danngreen/ir-remote/pcb/production/jlcpcb-ordered-downloaded/parts not placed.xlsx

?Designator | Value | Footprint | Quantity
L3 | 10uH_0805_0.5A | 0805 | 1
U1 | STM32G431CBTx | LQFP-48_7x7mm_P0.5mm | 1
R4 | 71.5k_0603 | R_0603 | 1
L11 | 4.7uH_1.2A_40xx | L_Taiyo-Yuden_NR-40xx | 1
R27 | 10.2k_0603 | R_0603 | 1
V12 | NCP51460SN33 | SOT23-3_PO132 | 1
R25 | 31.6k_0603 | R_0603 | 1
J12 | Conn_01x04 | Pins_1x04_2.54mm_TH_SWD | 1
TP1,TP11,TP12,TP13,TP14,TP2,TP3,TP4,TP5,TP6,TP7,TP8 | TestPoint | TestPoint_WireHole | 12
J1,J2,J8 | Conn_01x02 | Pins_1x02_2.54mm_TH | 3
J6 | Conn_01x03 | Pins_1x03_2.54mm_TH | 1
J3 | Pins_02x04_P2.54mm_SMT | Pins_2x04_P2.54mm_Vertical_SMD | 1
