danngreen/ir-remote/pcb/production/jlcpcb-ordered-downloaded/parts used.xls

Comment | Designator | Footprint | JLCPCB Part #
47nF_0603_35V | C22,C23 | C_0603 | C1622
USBLC6-2SC6 | U6 | SOT-23-6 | C2827654
DRV8210DRLR | U7 | SOT-563 | C3681297
TAR5S33U | U8 | SOT-563-5 | C3745113
47pF_0603_50V | C7,C8 | C_0603 | C1671
22uF_1206_25V | C17,C18,C36,C37,C39 | C_1206 | C12891
27Ω_0603 | R2,R3,R6,R7,R8 | R_0603 | C23140
100nF_0603_16V | C1,C12,C14,C3,C33,C9,C31,C34,C35,C4 | C_0603 | C14663
100k_0603 | R14,R15,R26 | R_0603 | C25803
USB-C_Receptacle_Molex_2171790001 | J4 | USB_C_Receptacle_Molex_2171790001 | C2894899
16MHz_18pF_FA238 | X10 | FA-238 | C13738
5.1k_0603 | R17,R18 | R_0603 | C23186
10uF_0603_10V | C10,C11,C13,C15,C27,C28,C29,C30,C5 | C_0603 | C19702
1k_0603 | R10,R11 | R_0603 | C21190
10uF_0805_25V | C303,C38,C6 | C_0805 | C15850
1uF_0402_25V | C300 | C_0402 | C52923
100Ω_0603 | R13,R16 | R_0603 | C22775
TLV61046ADB | U112 | SOT-23-6 | C464815
15k_0603 | R1 | R_0603 | C22809
2.2uF_0603_25V | C40 | C_0603 | C23630
TLV74018 | U3,U4 | SOT-23-5 | C3746861
1uF_0603_25V | C16,C19,C2,C20,C21,C26,C32 | C_0603 | C15849
AP62200WU-7 | V11 | TSOT-23-6 | C1323282
TLV320AIC3204 | U5 | QFN-32-1EP_5x5mm_P0.5mm_EP3.45x3.45mm_ThermalVias | C24109
10k_0603 | R5 | R_0603 | C25804
4.7k_0603 | R12,R9 | R_0603 | C23162
18pF_0603_50V | C24,C25 | C_0603 | C1647
