danngreen/ir-remote/pcb/production/jlcpcb-ordered-downloaded/gerbers/yg/GBR_10535677_1_bottom.png

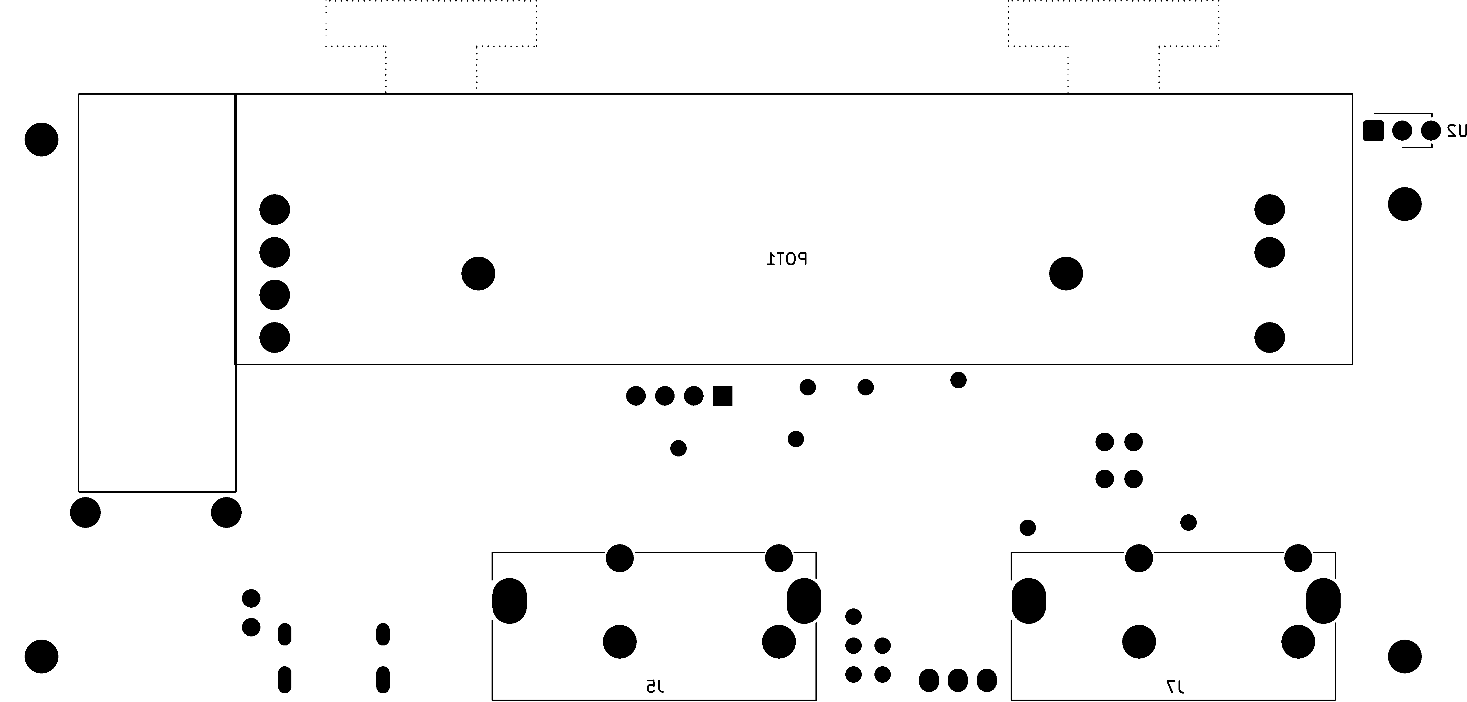
pcb/production/jlcpcb-ordered-downloaded/gerbers/yg/GBR_10535677_1_bottom.png
