danngreen/ir-remote/pcb/production/jlcpcb-ordered-downloaded/gerbers/yg/GBR_10535677_1_snapshot.png

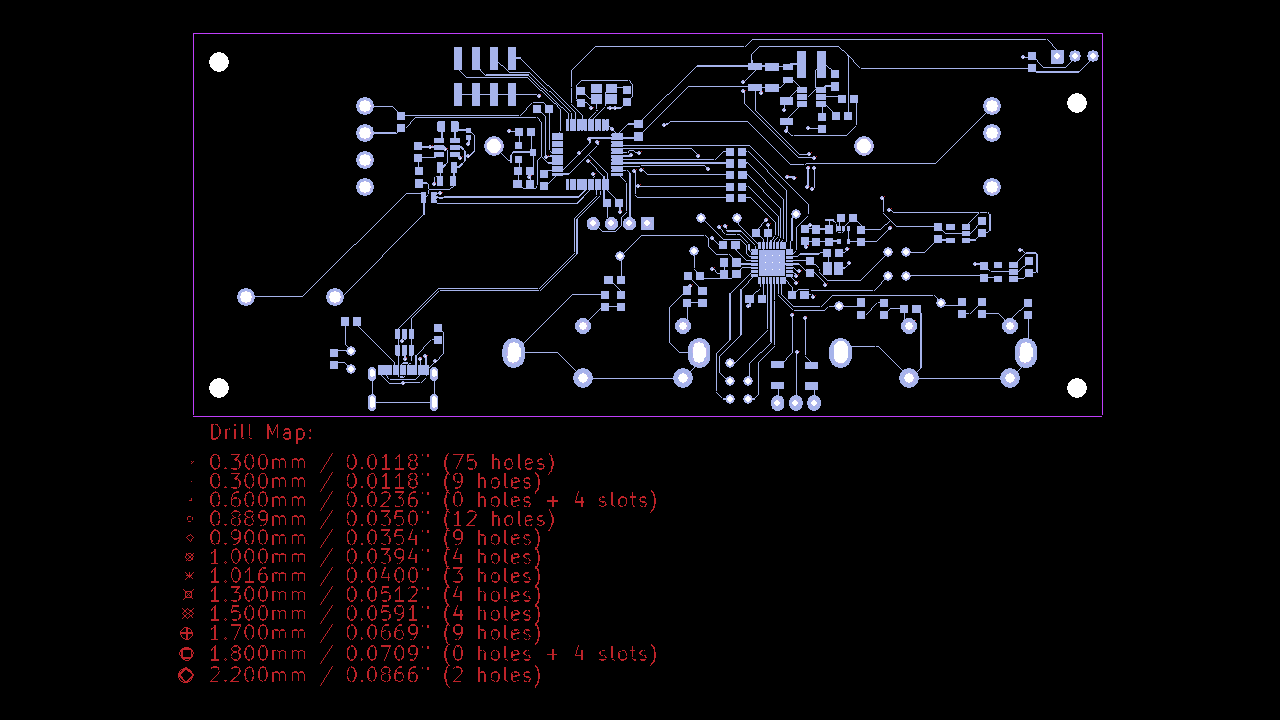
pcb/production/jlcpcb-ordered-downloaded/gerbers/yg/GBR_10535677_1_snapshot.png
