danngreen/ir-remote/enclosure/enclosure.FCStd

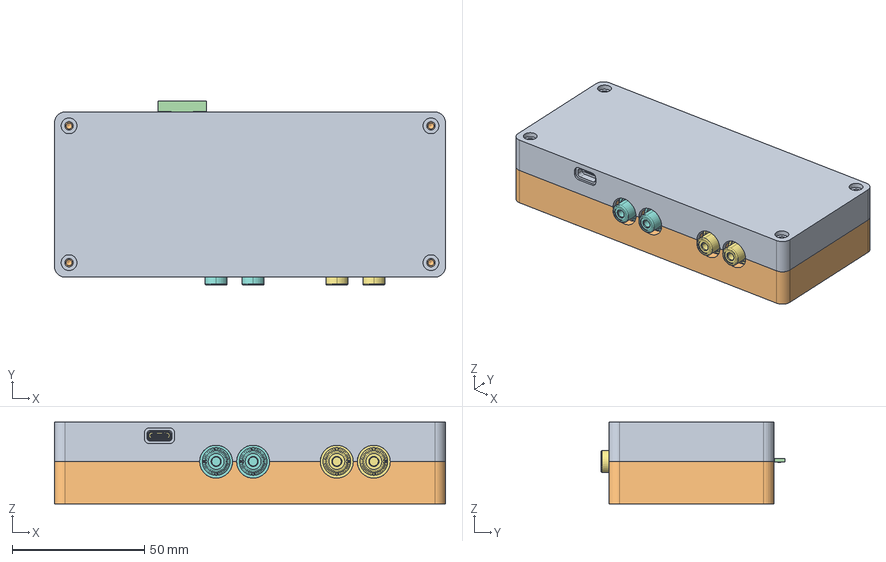
[picture p4: CAD file, 2026-01-19]
enclosure/enclosure.FCStd
147.9 x 69.8 x 31.0 mm
Bottom Enclosure
Top Enclosure
C_0603_1608Metric
C_0603_1608Metric066
C_1206_3216Metric
C_0603_1608Metric067
C_0603_1608Metric068
C_0603_1608Metric069
C_0603_1608Metric070
C_0603_1608Metric071
C_0603_1608Metric072
SOT-23-6
C_0603_1608Metric073
C_1206_3216Metric010
C_0603_1608Metric074
C_0603_1608Metric075
C_0603_1608Metric076
C_0603_1608Metric077
C_0603_1608Metric078
C_1206_3216Metric011
C_0603_1608Metric079
C_0603_1608Metric080
C_0603_1608Metric081
C_0603_1608Metric082
C_0603_1608Metric083
C_0603_1608Metric084
C_0603_1608Metric085
LQFP-48_7x7mm_P0.5mm
C_0603_1608Metric086
C_0603_1608Metric087
C_0603_1608Metric088
C_0603_1608Metric089
QFN-32-1EP_5x5mm_P0.5mm_EP3.45x3.45mm
C_1206_3216Metric012
C_0805_2012Metric
C_0603_1608Metric090
C_0603_1608Metric091
C_1206_3216Metric013
C_0603_1608Metric092
C_0603_1608Metric093
C_0603_1608Metric094
TSOT-23-6
C_0603_1608Metric095
C_0805_2012Metric006
C_0603_1608Metric096
SOT-23-010
C_0603_1608Metric097
SOT-563
C_0805_2012Metric007
C_0402_1005Metric
Vishay_MINICAST-3Pin
pjras2x1s_series
pjras2x1s_series005
ir-remote_PCB
