danngreen/ir-remote/enclosure/production/enclosure-top.step

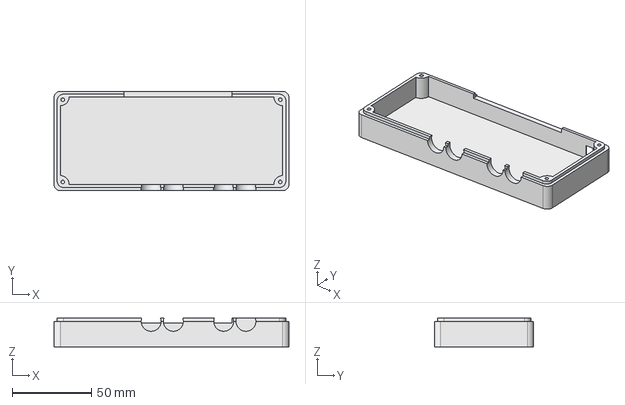
[picture p5: CAD file, 2026-01-19]
enclosure/production/enclosure-top.step
147.9 x 62.5 x 18.0 mm
