danngreen/ir-remote/enclosure/production/enclosure-bottom.step

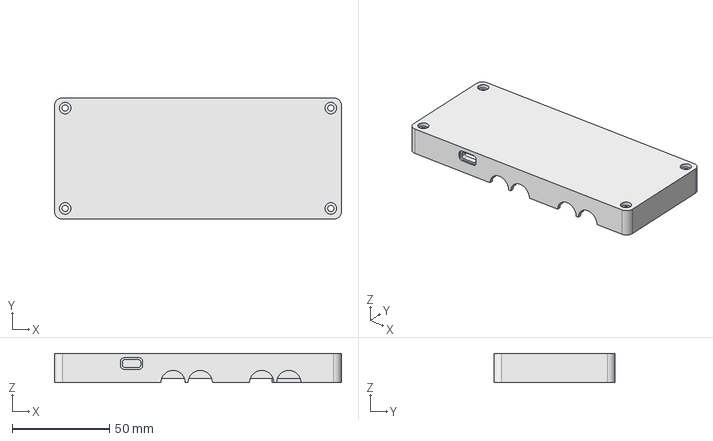
[picture p6: CAD file, 2026-01-19]
enclosure/production/enclosure-bottom.step
147.9 x 62.5 x 15.0 mm
