danngreen/ir-remote/pcb/ir-remote.kicad_pcb

## KiCad design pcb/ir-remote.kicad_pcb (2026-01-19)

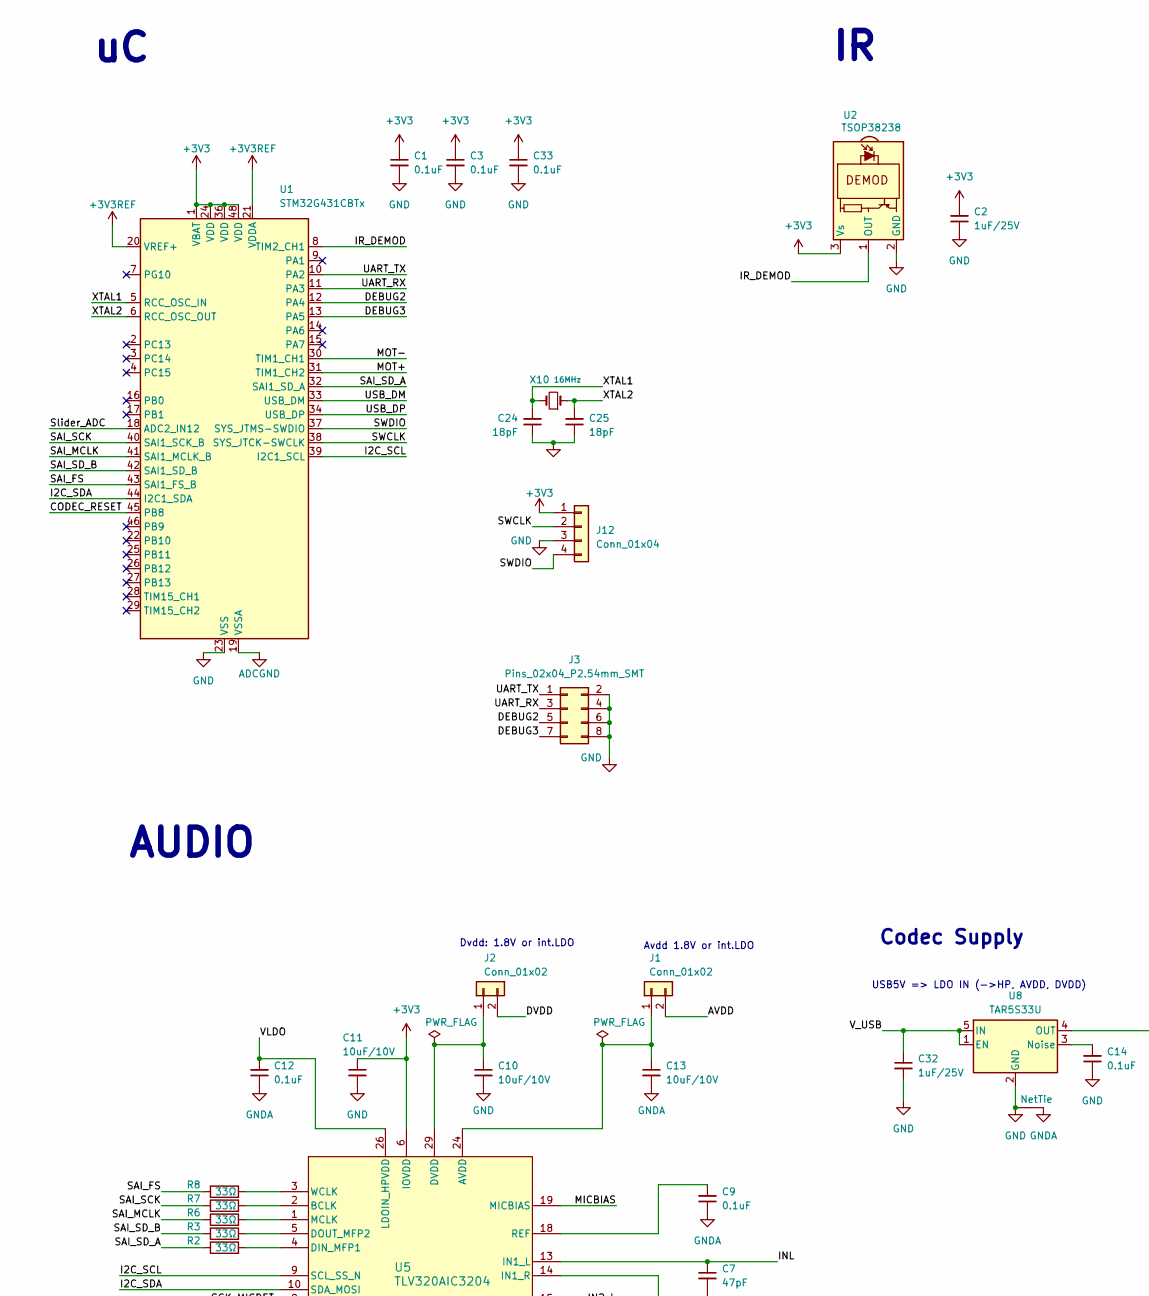
[picture p7: schematic ir-remote.kicad_sch, part in row 1, column 1]

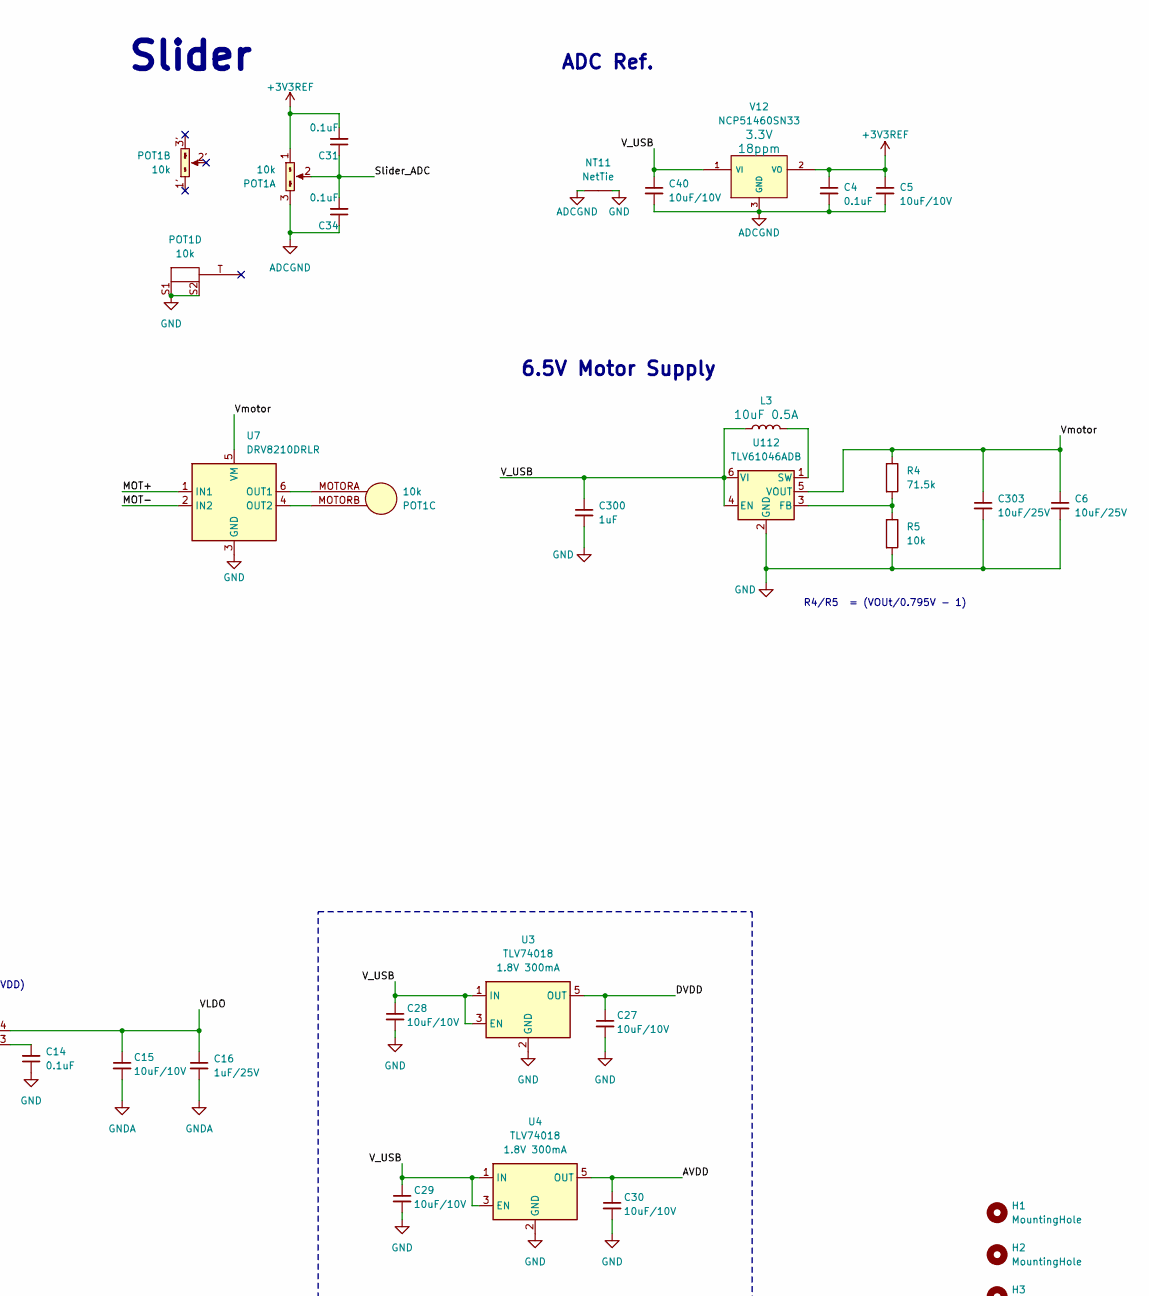
[picture p8: schematic ir-remote.kicad_sch, part in row 1, column 2]

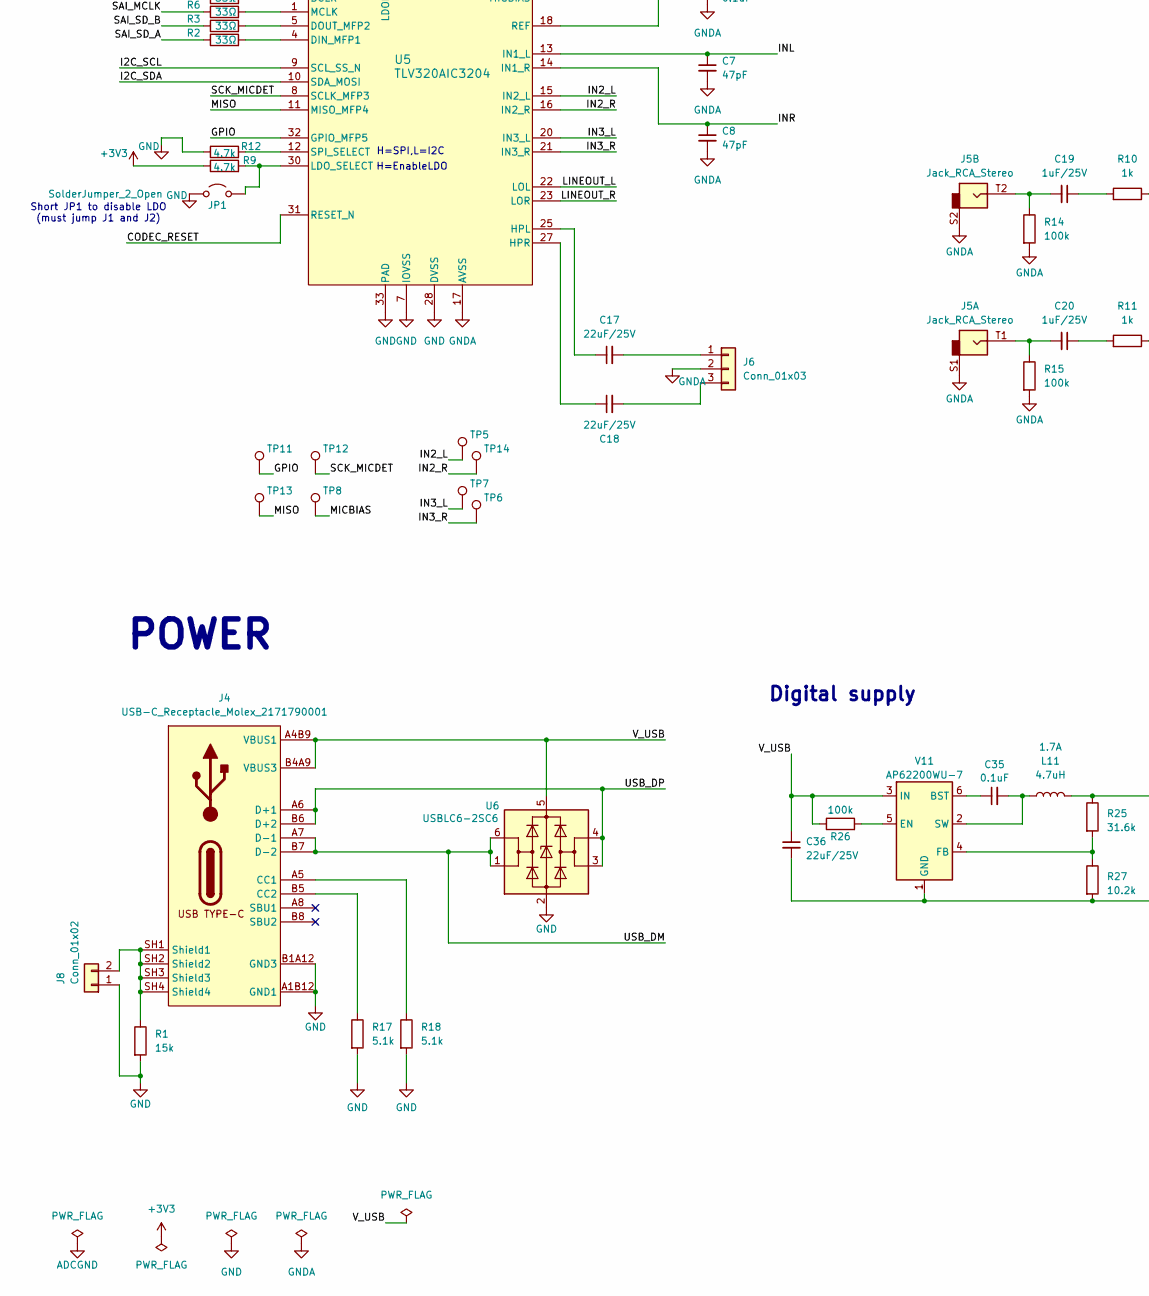
[picture p9: schematic ir-remote.kicad_sch, part in row 2, column 1]

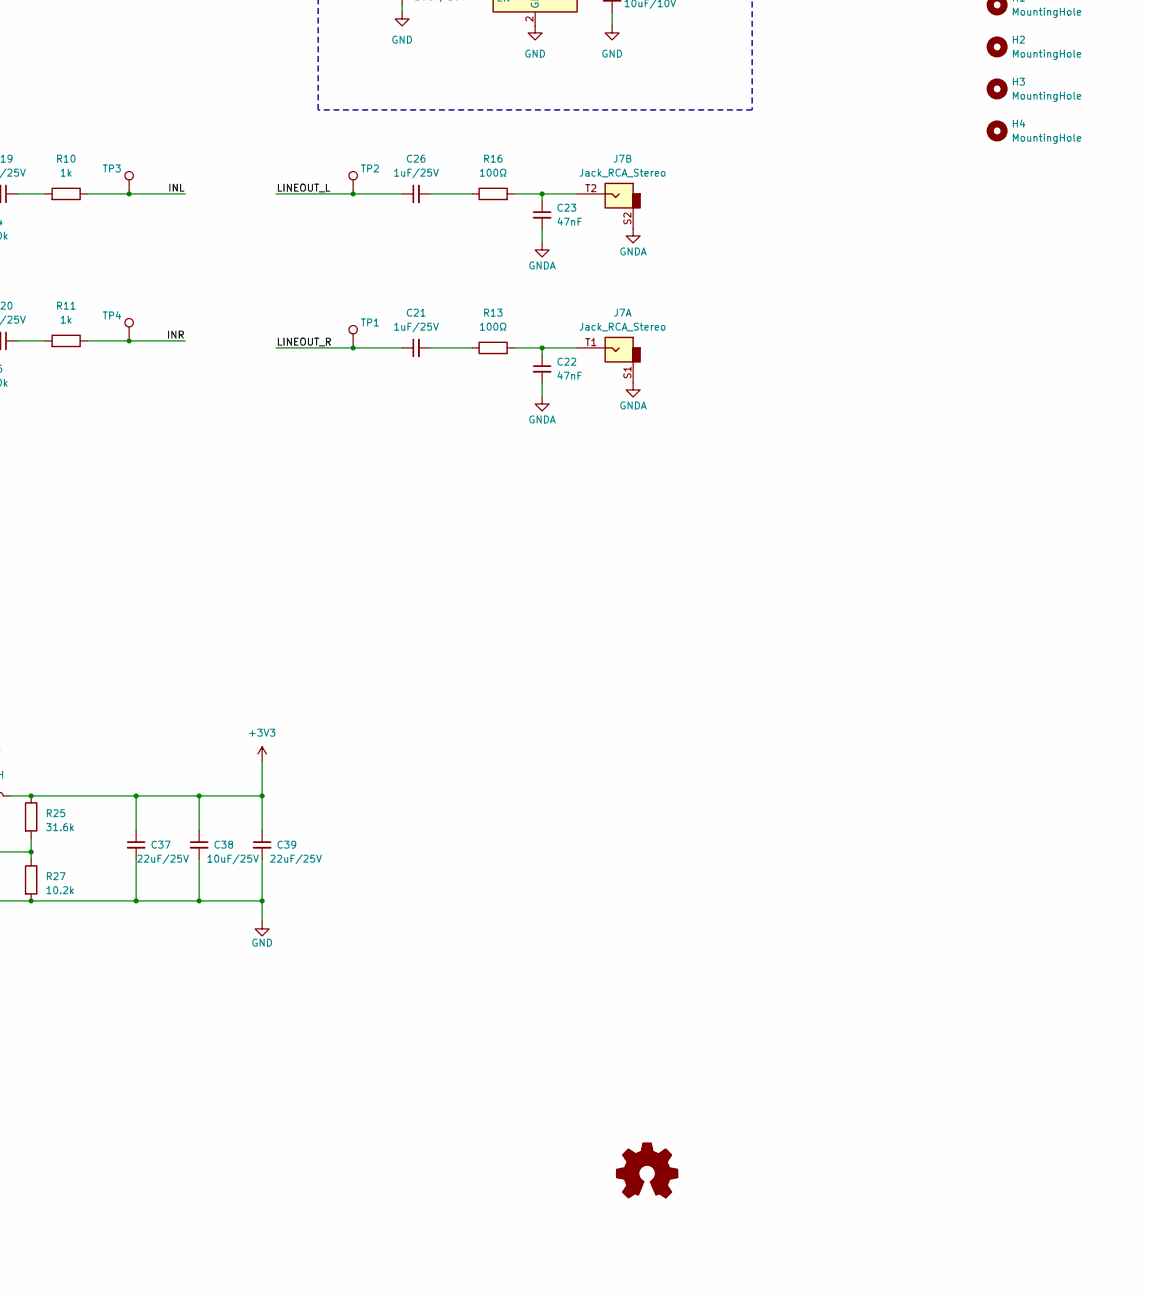
[picture p10: schematic ir-remote.kicad_sch, part in row 2, column 2]

Parts:
C1, C3, C9, C12, C14, C33: 0.1uF_0603_16V; C_0603; Part Number 0603YC104KAT2A; JLCPCB ID C14663
C2, C16, C19, C20, C21, C26, C32: 1uF_0603_25V; C_0603; Part Number GRM188R61E105KA12D; JLCPCB ID C15849
C4, C31, C34, C35: 100nF_0603_16V; C_0603; Part Number 0603YC104KAT2A; JLCPCB ID C14663
C5, C10, C11, C13, C15, C27, C28, C29, C30, C40: 10uF_0603_10V; C_0603; Part Number GRM188R61A106KE69D; JLCPCB ID C19702
C6, C38, C303: 10uF_0805_25V; C_0805; Part Number GRM21BR61E106MA73L; JLCPCB ID C15850
C7, C8: 47pF_0603_50V; C_0603; Part Number CC0603JRNPO9BN470; JLCPCB ID C1671
C17, C18, C36, C37, C39: 22uF_1206_25V; C_1206; Part Number TMK316BBJ226ML-T; JLCPCB ID C12891
C22, C23: 47nF_0603_35V; C_0603; Part Number CC0603KRX7R9BB473; JLCPCB ID C1622
C24, C25: 18pF_0603_50V; C_0603; Part Number C0603C180J5GACTU; JLCPCB ID C1647
C300: 1uF_0402_25V; C_0402; Part Number GMK105CC6105KV-F; JLCPCB ID C52923
H1, H2, H3, H4: MountingHole; MountingHole_Screw_3mmHole_5.3mmHead
J1, J2, J8: Conn_01x02; Pins_1x02_2.54mm_TH; Part Number 1-0201FBV0T
J3: Pins_02x04_P2.54mm_SMT; Pins_2x04_P2.54mm_Vertical_SMD; Part Number TSM-104-01-F-DV
J4: USB-C_Receptacle_Molex_2171790001; USB_C_Receptacle_Molex_2171790001; Part Number 217179-0001; JLCPCB ID C2894899
J5, J7: Jack_RCA_Stereo; RCA_Stereo_SwitchCraft-PJRAS2X1S; Part Number PJRAS2X1S01AUX
J6: Conn_01x03; Pins_1x03_2.54mm_TH; Part Number 1-0301FBV0T
J12: Conn_01x04; Pins_1x04_2.54mm_TH_SWD; Part Number 1-0401FBV0T
JP1: SolderJumper_2_Open; JUMPER_SMD_1x2
L3: 10uH_0805_0.5A; R_0805_2012Metric; Part Number MLZ2012N100L; JLCPCB ID C88182
L11: 4.7uH_1.2A_40xx; L_Taiyo-Yuden_NR-40xx; Part Number NRS4018T4R7MDGJ; JLCPCB ID C92936
NT2, NT11: NetTie; NetTie-2_SMD_Pad0.16mm_6mil; Part Number Do Not Place
POT1: Slider_Dual_Motorized_PSM60-081A-xxx; Part Number PSM60-081A-103B2
R1: 15k_0603; R_0603; Part Number RC0603FR-0715KL; JLCPCB ID C114661
R2, R3, R6, R7, R8: 33Ω_0603; R_0603; Part Number RC0603FR-0733RL; JLCPCB ID C23140
R4: 71.5k_0603; R_0603; Part Number RC0603FR-0771K5L; JLCPCB ID C185312
R5: 10k_0603; R_0603; Part Number RC0603FR-0710KL; JLCPCB ID C98220
R9, R12: 4.7k_0603; R_0603; Part Number RC0603FR-074K7L; JLCPCB ID C99782
R10, R11: 1k_0603; R_0603; Part Number RC0603FR-071KL; JLCPCB ID C22548
R13, R16: 100Ω_0603; R_0603; Part Number RC0603FR-07100RL; JLCPCB ID C105588
R14, R15, R26: 100k_0603; R_0603; Part Number RC0603FR-07100KL; JLCPCB ID C14675
R17, R18: 5.1k_0603; R_0603; Part Number RC0603FR-075K1L; JLCPCB ID C105580
R25: 31.6k_0603; R_0603; Part Number RC0603FR-0731K6L; JLCPCB ID C185339
R27: 10.2k_0603; R_0603; Part Number RC0603FR-0710K2L; JLCPCB ID C183219
TP1, TP2, TP3, TP4, TP5, TP6, TP7, TP8, TP11, TP12, TP13, TP14: TestPoint; TestPoint_WireHole
U1: STM32G431CBTx; LQFP-48_7x7mm_P0.5mm; JLCPCB ID C529355
U2: TSOP38238; Vishay_MINICAST-3Pin
U3, U4: TLV74018; SOT-23-5; Part Number TLV74018PDBVR; JLCPCB ID C3746861
U5: TLV320AIC3204; QFN-32-1EP_5x5mm_P0.5mm_EP3.45x3.45mm_ThermalVias; Part Number TLV320AIC3204IRHBR; JLCPCB ID C24109
U6: USBLC6-2SC6; SOT-23-6; Part Number USBLC6-2SC6; JLCPCB ID C2827654
U7: DRV8210DRLR; SOT-563; Part Number DRV8210DRLR; JLCPCB ID C3681297
U8: TAR5S33U; SOT-563-5; Part Number TAR5S33UTE85LF; JLCPCB ID C3745113
U112: TLV61046ADB; SOT-23-6; Part Number TLV61046ADBVR; JLCPCB ID C464815
V11: AP62200WU-7; TSOT-23-6; Part Number AP62200WU7; JLCPCB ID C1323282
V12: NCP51460SN33; SOT23-3_PO132; Part Number NCP51460SN33T1G; JLCPCB ID C233715
X10: 16MHz_18pF_FA238; FA-238; Part Number TSX-3225 16.0000MF18X-AC3; JLCPCB ID C90906

Connections:
+3V3: C1.1, C2.2, C3.1, C11.1, C33.1, C37.1, C38.1, C39.1, J12.1, L11.2, R9.1, R25.1, U1.1 (VBAT), U1.24 (VDD), U1.36 (VDD), U1.48 (VDD), U2.3 (Vs), U5.6 (IOVDD)
+3V3REF: C4.1, C5.1, C31.2, POT1.1 (Left), U1.20 (VREF+), U1.21 (VDDA), V12.2 (VO)
/AVDD: C30.1, J1.2, U4.5 (OUT)
/CODEC_RESET: U1.45 (PB8), U5.31 (RESET_N)
/DEBUG2: J3.5, U1.12 (PA4)
/DEBUG3: J3.7, U1.13 (PA5)
/DVDD: C27.1, J2.2, U3.5 (OUT)
/GPIO: TP11.1, U5.32 (GPIO_MFP5)
/I2C_SCL: U1.39 (I2C1_SCL), U5.9 (SCL_SS_N)
/I2C_SDA: U1.44 (I2C1_SDA), U5.10 (SDA_MOSI)
/IN2_L: TP5.1, U5.15 (IN2_L)
/IN2_R: TP14.1, U5.16 (IN2_R)
/IN3_L: TP7.1, U5.20 (IN3_L)
/IN3_R: TP6.1, U5.21 (IN3_R)
/INL: C7.1, R10.1, TP3.1, U5.13 (IN1_L)
/INR: C8.1, R11.1, TP4.1, U5.14 (IN1_R)
/IR_DEMOD: U1.8 (TIM2_CH1), U2.1 (OUT)
/LINEOUT_L: C26.1, TP2.1, U5.22 (LOL)
/LINEOUT_R: C21.1, TP1.1, U5.23 (LOR)
/MICBIAS: TP8.1, U5.19 (MICBIAS)
/MISO: TP13.1, U5.11 (MISO_MFP4)
/MOT+: U1.31 (TIM1_CH2), U7.1 (IN1)
/MOT-: U1.30 (TIM1_CH1), U7.2 (IN2)
/SAI_FS: R8.1, U1.43 (SAI1_FS_B)
/SAI_MCLK: R6.1, U1.41 (SAI1_MCLK_B)
/SAI_SCK: R7.1, U1.40 (SAI1_SCK_B)
/SAI_SD_A: R2.1, U1.32 (SAI1_SD_A)
/SAI_SD_B: R3.1, U1.42 (SAI1_SD_B)
/SCK_MICDET: TP12.1, U5.8 (SCLK_MFP3)
/SWCLK: J12.2, U1.38 (SYS_JTCK-SWCLK)
/SWDIO: J12.4, U1.37 (SYS_JTMS-SWDIO)
/Slider_ADC: C31.1, C34.2, POT1.2 (Center), U1.18 (ADC2_IN12)
/UART_RX: J3.3, U1.11 (PA3)
/UART_TX: J3.1, U1.10 (PA2)
/USB_DM: J4.A7 (D-1), J4.B7 (D-2), U1.33 (USB_DM), U6.1 (I/O1), U6.6 (I/O1)
/USB_DP: J4.A6 (D+1), J4.B6 (D+2), U1.34 (USB_DP), U6.3 (I/O2), U6.4 (I/O2)
/VLDO: C12.2, C15.1, C16.1, U5.26 (LDOIN_HPVDD), U8.4 (OUT)
/V_USB: C28.1, C29.1, C32.1, C36.1, C40.1, C300.1, J4.A4B9 (VBUS1), J4.B4A9 (VBUS3), L3.1, R26.1, U3.1 (IN), U3.3 (EN), U4.1 (IN), U4.3 (EN), U6.5 (VBUS), U8.1 (EN), U8.5 (IN), U112.4 (EN), U112.6 (VI), V11.3 (IN), V12.1 (VI)
/Vmotor: C6.1, C303.1, R4.1, U7.5 (VM), U112.5 (VOUT)
/XTAL1: C24.2, U1.5 (RCC_OSC_IN), X10.2
/XTAL2: C25.2, U1.6 (RCC_OSC_OUT), X10.1
ADCGND: C4.2, C5.2, C34.1, C40.2, NT11.1, POT1.3 (Right), U1.19 (VSSA), V12.3 (GND)
GND: C1.2, C2.1, C3.2, C6.2, C10.2, C11.2, C14.1, C24.1, C25.1, C27.2, C28.2, C29.2, C30.2, C32.2, C33.2, C36.2, C37.2, C38.2, C39.2, C300.2, C303.2, J3.2, J3.4, J3.6, J3.8, J4.A1B12 (GND1), J4.B1A12 (GND3), J8.1, J12.3, JP1.1 (A), NT2.1, NT11.2, POT1.S1 (GND), POT1.S2 (GND), R1.2, R5.2, R12.1, R17.2, R18.2, R27.2, U1.23 (VSS), U1.35 (VSS), U1.47 (VSS), U2.2 (GND), U3.2 (GND), U4.2 (GND), U5.7 (IOVSS), U5.28 (DVSS), U5.33 (PAD), U6.2 (GND), U7.3 (GND), U8.2 (GND), U112.2 (GND), V11.1 (GND)
GNDA: C7.2, C8.2, C9.1, C12.1, C13.2, C15.2, C16.2, C22.2, C23.2, J5.S1, J5.S2, J6.2, J7.S1, J7.S2, NT2.2, R14.2, R15.2, U5.17 (AVSS)
unnamed: C19.1, R10.2
unnamed: C19.2, J5.T2, R14.1
unnamed: C20.1, R11.2
unnamed: C20.2, J5.T1, R15.1
unnamed: C21.2, R13.1
unnamed: C22.1, J7.T1, R13.2
unnamed: C23.1, J7.T2, R16.2
unnamed: C26.2, R16.1
unnamed: C13.1, J1.1, U5.24 (AVDD)
unnamed: C10.1, J2.1, U5.29 (DVDD)
unnamed: J4.A5 (CC1), R18.1
unnamed: J4.B5 (CC2), R17.1
unnamed: J4.SH1 (Shield1), J4.SH2 (Shield2), J4.SH3 (Shield3), J4.SH4 (Shield4), J8.2, R1.1
unnamed: C17.2, J6.1
unnamed: C18.2, J6.3
unnamed: JP1.2 (B), R9.2, U5.30 (LDO_SELECT)
unnamed: R7.2, U5.2 (BCLK)
unnamed: R2.2, U5.4 (DIN_MFP1)
unnamed: R3.2, U5.5 (DOUT_MFP2)
unnamed: C17.1, U5.25 (HPL)
unnamed: C18.1, U5.27 (HPR)
unnamed: R6.2, U5.1 (MCLK)
unnamed: C9.2, U5.18 (REF)
unnamed: R12.2, U5.12 (SPI_SELECT)
unnamed: R8.2, U5.3 (WCLK)
unnamed: POT1.MOTORA, U7.6 (OUT1)
unnamed: POT1.MOTORB, U7.4 (OUT2)
unnamed: C14.2, U8.3 (Noise)
unnamed: R4.2, R5.1, U112.3 (FB)
unnamed: L3.2, U112.1 (SW)
unnamed: C35.1, V11.6 (BST)
unnamed: R26.2, V11.5 (EN)
unnamed: R25.2, R27.1, V11.4 (FB)
unnamed: C35.2, L11.1, V11.2 (SW)

Notes on the sheet:
H=SPI,L=I2C
Slider
Codec Supply
R4/R5 = (VOUt/0.795V - 1)
POWER
H=EnableLDO
Digital supply
Dvdd: 1.8V or int.LDO
USB5V => LDO IN (->HP, AVDD, DVDD)
Avdd 1.8V or int.LDO
Short JP1 to disable LDO (must jump J1 and J2)
AUDIO
6.5V Motor Supply
ADC Ref.

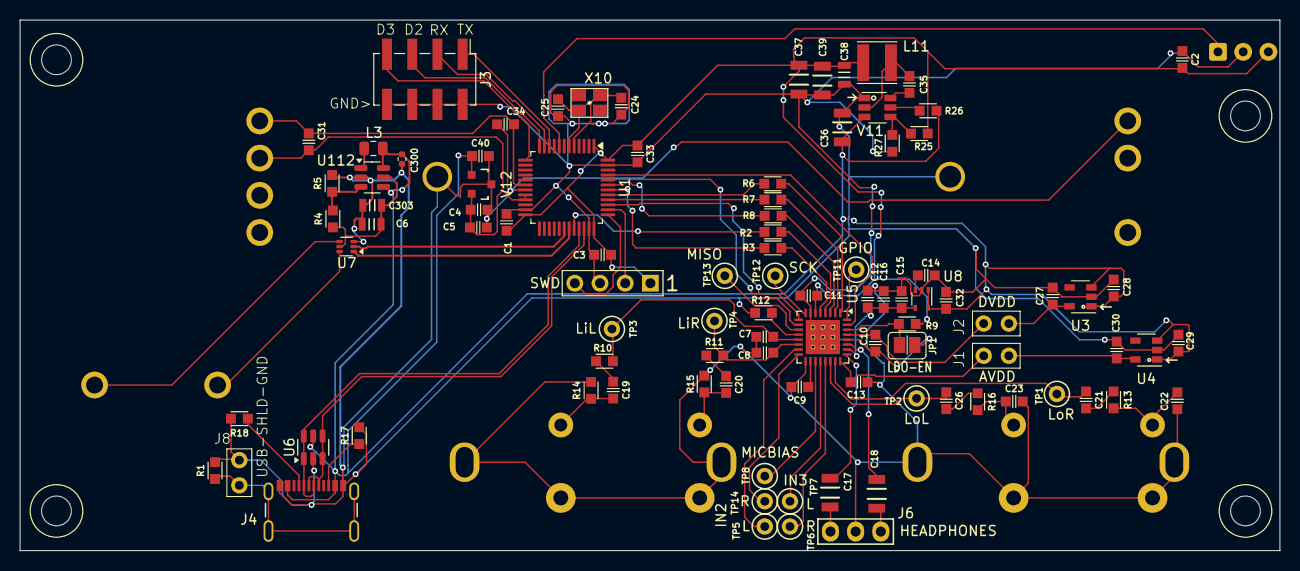
[picture p11: board ir-remote.kicad_pcb from above]

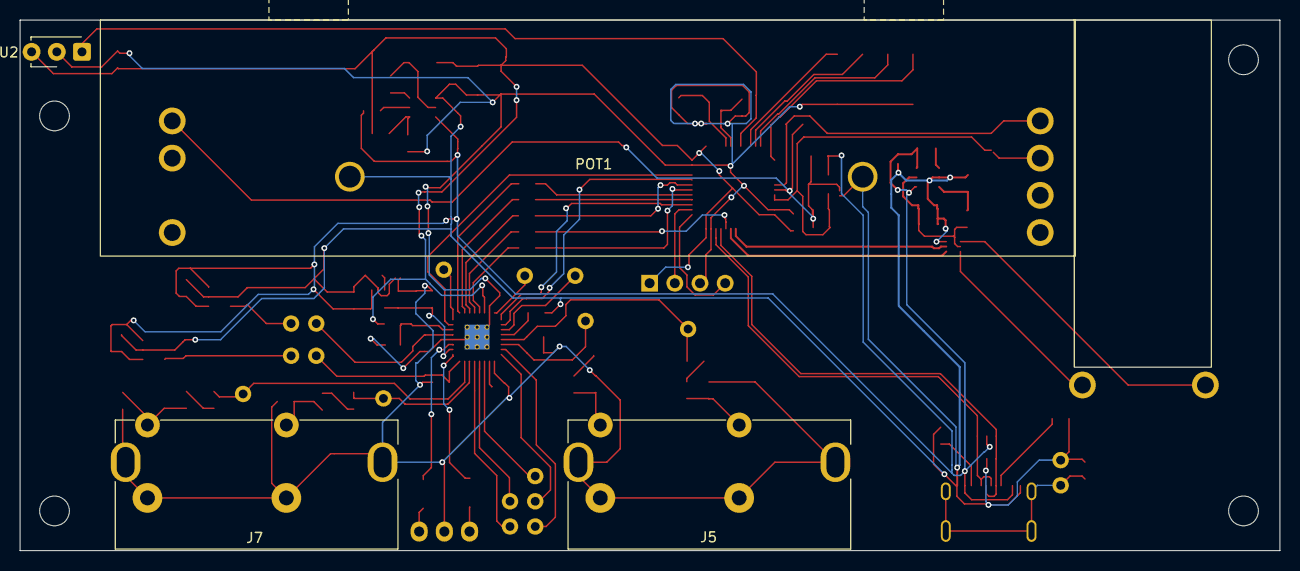
[picture p12: board ir-remote.kicad_pcb from below]

Board: 2 copper layers, 127.0 x 53.5 mm, 106 parts (4 on the bottom side), 78 nets.
