danngreen/ir-remote/cubemx/ir-remote.ioc

Mcu.UserName=STM32G431CBTx
PA10.Signal=SAI1_SD_A
PA11.Signal=USB_DM
PA12.Signal=USB_DP
PA13.Signal=SYS_JTMS-SWDIO
PA14.Signal=SYS_JTCK-SWCLK
PA15.Signal=I2C1_SCL
PA2.Signal=USART2_TX
PA3.Signal=USART2_RX
PB2.Signal=ADC2_IN12
PB3.Signal=SAI1_SCK_B
PB4.Signal=SAI1_MCLK_B
PB5.Signal=SAI1_SD_B
PB6.Signal=SAI1_FS_B
PB7.Signal=I2C1_SDA
PF0-OSC_IN.Signal=RCC_OSC_IN
PF1-OSC_OUT.Signal=RCC_OSC_OUT
