danngreen/ir-remote/(commit log)

2025-12-08 Made ir receiver into a class
    Revert edits to stm32cubemx/CMakeLists (except main.c=>main.cc)
    [capture.cc, main.cc]
2025-12-15 Add schematic and PCB (WIP)
    [ir-remote.kicad_pcb, ir-remote.kicad_sch]
2025-12-19 PCB WIP
    [ir-remote.kicad_pcb, ir-remote.kicad_sch]
2026-01-02 PCB routed and ready for review
    [bom.csv, designators.csv, ir-remote.kicad_pcb, ir-remote.kicad_sch, positions.csv]
2026-01-02 Adjust PCB edges and mounting holes to fit enclosure
    [ir-remote.kicad_pcb, ir-remote.kicad_sch]
2026-01-02 Enclosure 3D started
    [enclosure.FCStd]
2026-01-02 Exported JLCPCB production files
    [bom.csv, designators.csv, positions.csv]
2026-01-02 WIP Enclosure
    [enclosure.FCStd, ir-remote.kicad_pcb]
2026-01-02 Remove rounded corners on PCB
    [ir-remote.kicad_pcb]
2026-01-03 Enclosure and PCB matched and fit
    [enclosure.FCStd, ir-remote.kicad_pcb]
2026-01-03 PCB: add missing 5.1k USB pull-downs
    [ir-remote.kicad_pcb, ir-remote.kicad_sch]
2026-01-04 Enclosure ordered
    [enclosure-bottom.step, enclosure-top.step, enclosure.FCStd]
2026-01-04 pcb: 20R=>33R, 2.2uF=>10uF. Change some JLC # to cheaper parts
    [bom.csv, designators.csv, ir-remote.kicad_pcb, ir-remote.kicad_sch, positions.csv]
2026-01-04 Added JLC pcb files downloaded after ordering
    Since several parts substitutions were made, this will help clarify
    [ir-remote-B_Cu.gbl, ir-remote-B_Mask.gbs, ir-remote-B_Paste.gbp, ir-remote-B_Silkscreen.gbo, ir-remote-Edge_Cuts.gm1, ir-remote-F_Cu.gtl, ir-remote-F_Mask.gts, ir-remote-F_Paste.gtp]
2026-01-19 Update mdrivlib (add stm32g4 arch)
2026-01-19 Note on PCB about jumper
    [ir-remote.kicad_sch]
2026-01-20 Motor test
2026-01-20 trace32 script
2026-01-20 ADC reading with DMA
2026-01-20 Update mdrivlib (ADC reading)
2026-01-20 I2C(working) and SAI(WIP)
2026-01-20 Update mdrivlib (SAI and I2C)
2026-02-10 Main: adc sets volume, used in audio callback
2026-02-11 Controls returns adc values in separate TU
    Gets around the compilers aggressive optimization of adc value without need to use volatile
2026-02-11 Add printf() support
2026-02-11 SCH: saved in latest kicad (no changes)
    [ir-remote.kicad_sch]
2026-05-29 Update mdrivlib (add UART sync flag)
2026-05-29 Init motor pins low
2026-05-29 Controls polls events and moves motor up/down
2026-05-29 Implement "repeat" remote button being held down
2026-05-29 Hold/repeat goes into PWM mode to continously drive the motor
2026-05-29 Set ADC min/max away from rails and scale volume accordingly
